anubhav96gupta/EMG-Analysis-and-Application-for-Arm-Exoskeleton-Control/Schematic/DIGITAL.pdf

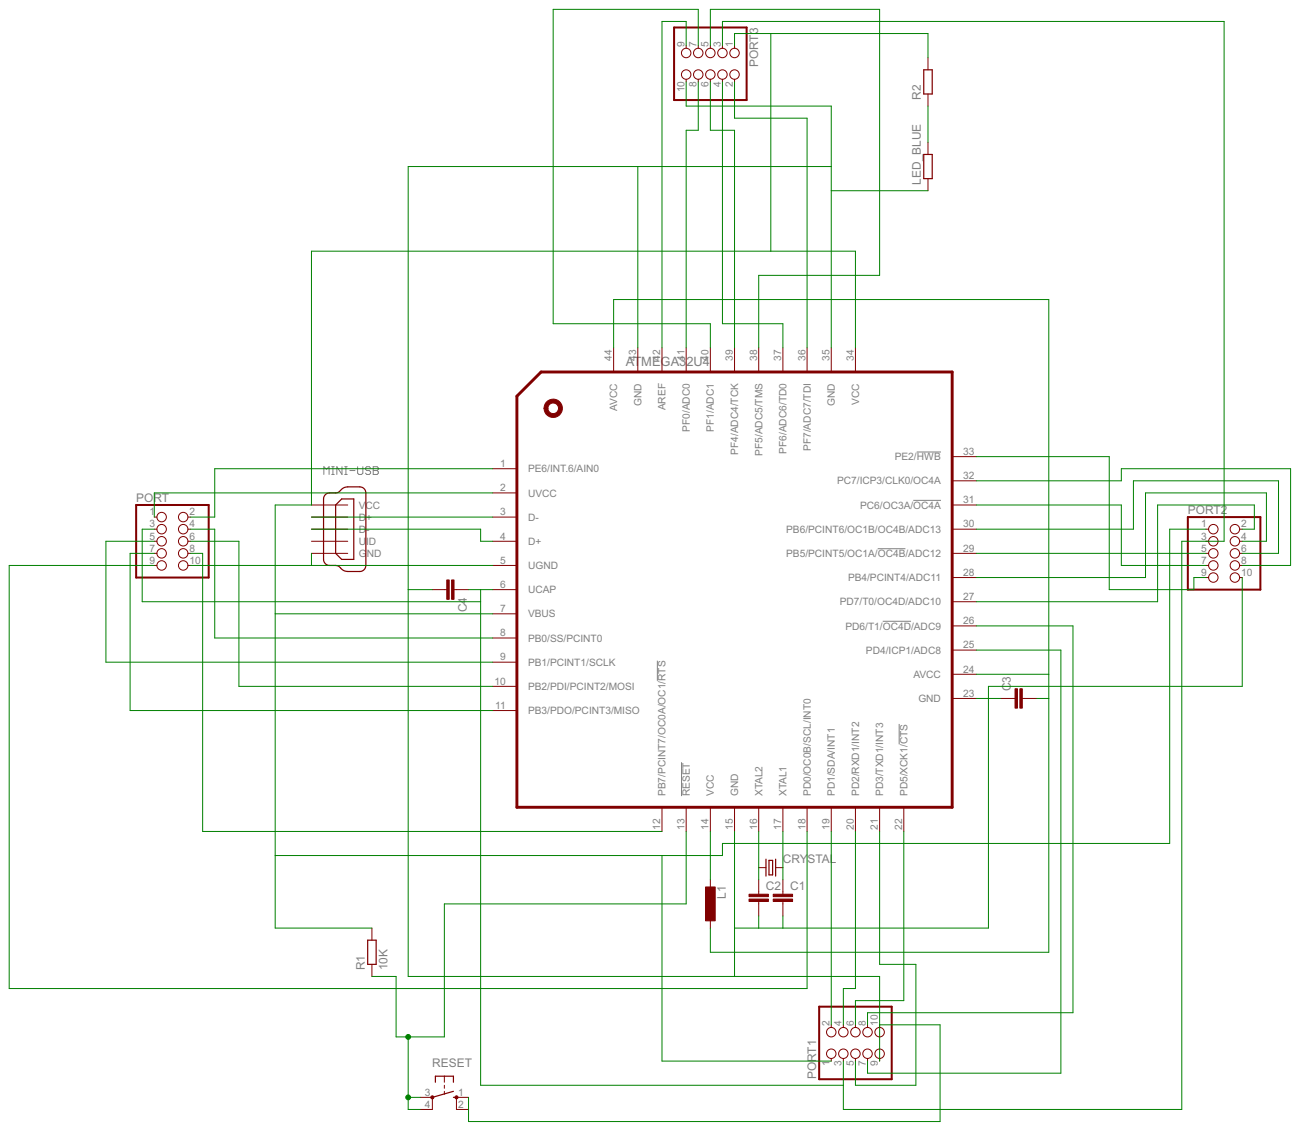
[picture p68: page 1]

10K ATMEGA32U4 PF0/ADC0 41 PF4/ADC4/TCK 39 PF5/ADC5/TMS 38 PB1/PCINT1/SCLK 9 GND 15 VCC 14 PD0/OC0B/SCL/INT0 18 AVCC 24 PF1/ADC1 40 AREF 42 PB2/PDI/PCINT2/MOSI 10 GND 23 PB7/PCINT7/OC0A/OC1/RTS 12 PD1/SDA/INT1 19 GND 35 PE2/HWB P33 F6/ADC6/TD0 37 PB3/PDO/PCINT3/MISO 11 PD2/RXD1/INT2 20 PD3/TXD1/INT3 21 PD5/XCK1/CTS 22 XTAL1 17 GND 43 PF7/ADC7/TDI 36 PB0/SS/PCINT0 8 PD4/ICP1/ADC8 25 PD6/T1/OC4D/ADC9 26 XTAL2 16 RESET 13 PC7/ICP3/CLK0/OC4A 32 PB4/PCINT4/ADC11 28 PD7/T0/OC4D/ADC10 27 D+ 4 D- 3 UCAP 6 PE6/INT.6/AIN0 1 PB5/PCINT5/OC1A/OC4B/ADC12 29 VCC 34 UVCC 2 AVCC 44 UGND 5 VBUS 7 PC6/OC3A/OC4A 31 PB6/PCINT6/OC1B/OC4B/ADC13 30 CRYSTAL C2 C1 L1 C3 VCC D+D- UID GND C4 PORT2 1 2 3 4 5 6 7 8 9 10 1 2 3 4 5 6 7 8 9 10 PORT3 PORT1 1 2 3 4 5 6 7 8 9 10 PORT 1 2 3 4 5 6 7 8 9 10 RESET 3 1 4 2 R1 R2 LED_BLUE
