anubhav96gupta/EMG-Analysis-and-Application-for-Arm-Exoskeleton-Control/Schematic/ANALOG.pdf

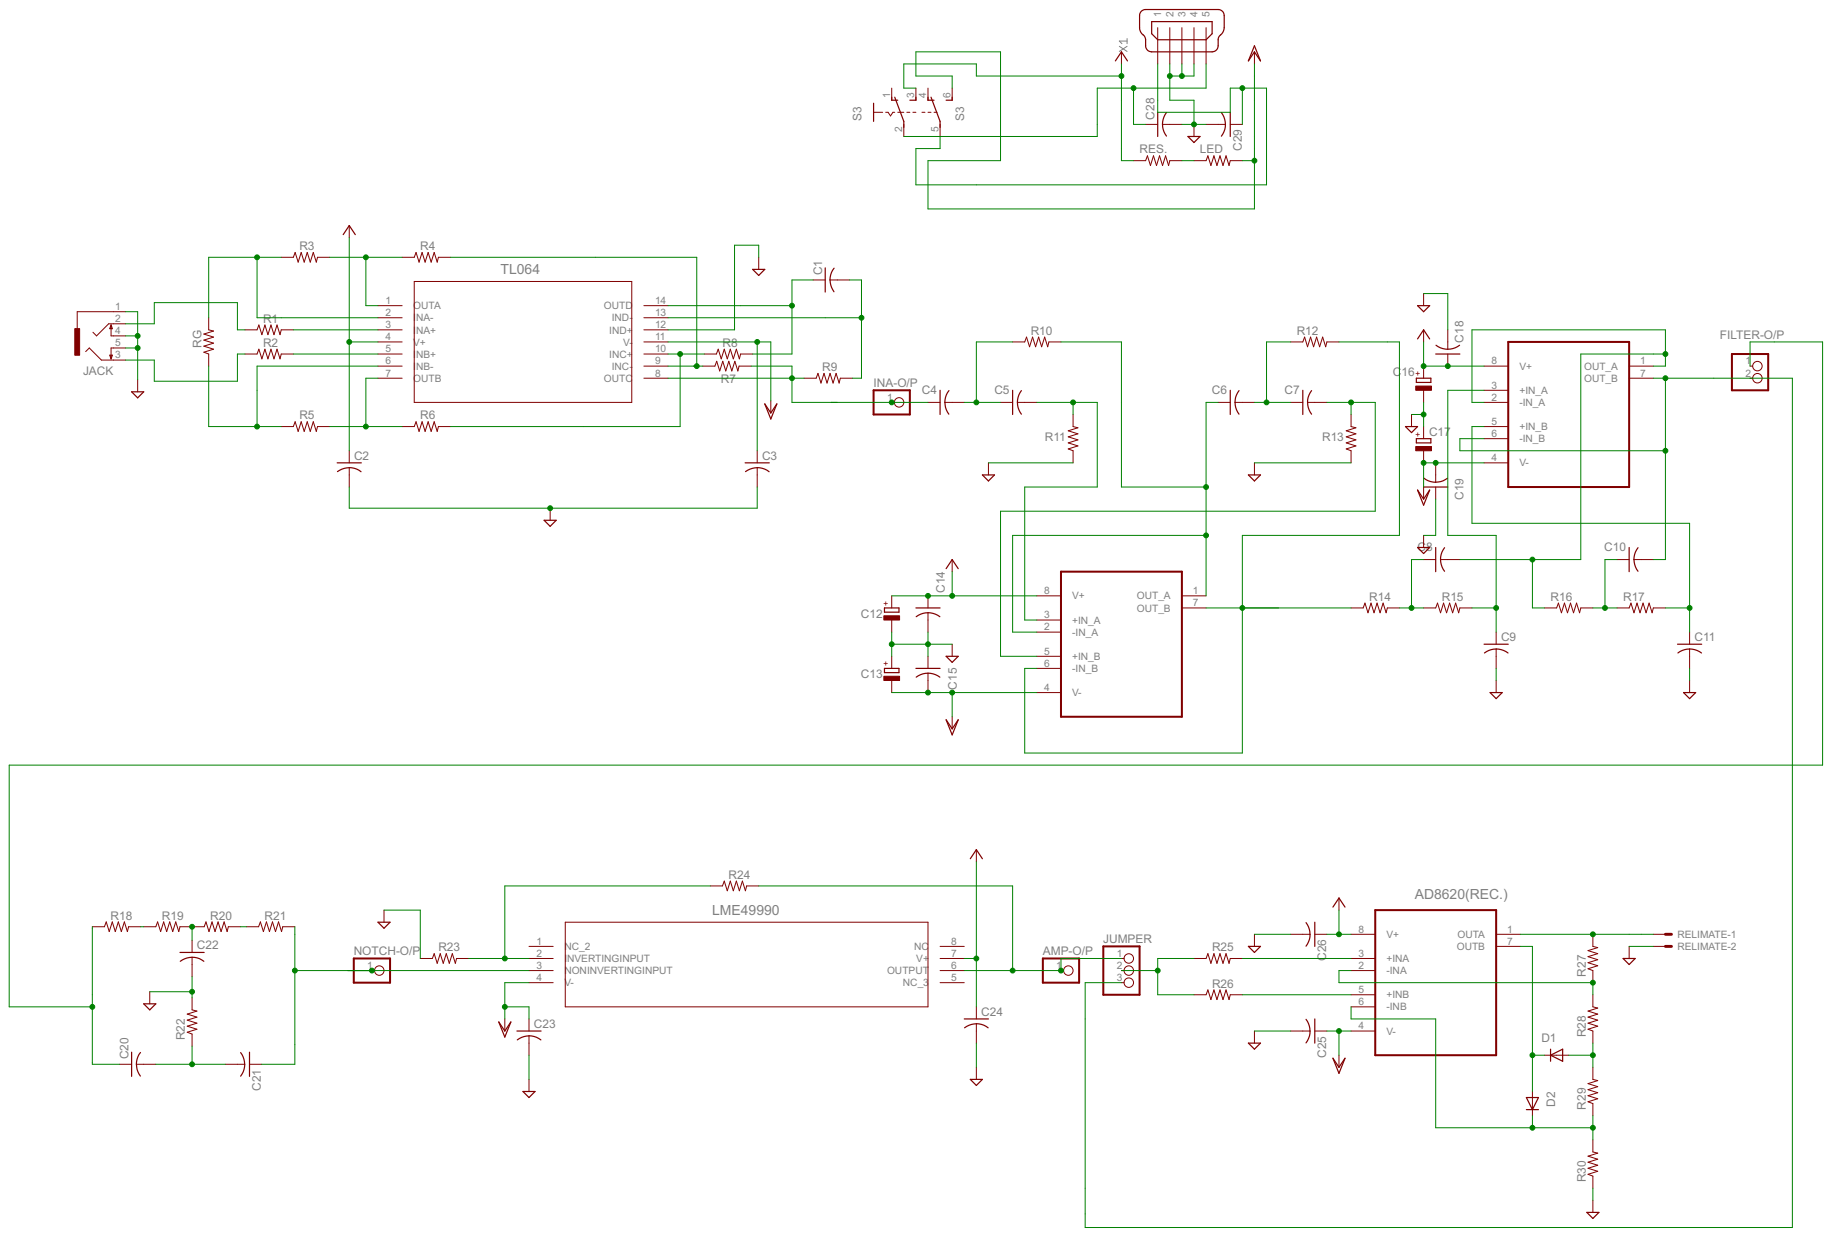
[picture p69: page 1]
