anubhav96gupta/EMG-Analysis-and-Application-for-Arm-Exoskeleton-Control/(list of files, drawings)

Other design files:
Multisim Circuits/hpf.ms12
Multisim Circuits/lpf.ms12
Multisim Circuits/Rectifier.ms12
Multisim Circuits/tl061notch.ms12
