anubhav96gupta/EMG-Analysis-and-Application-for-Arm-Exoskeleton-Control/Eagle/Digital/Socket.brd

## EAGLE design Eagle/Digital/Socket.brd (2016-12-27)

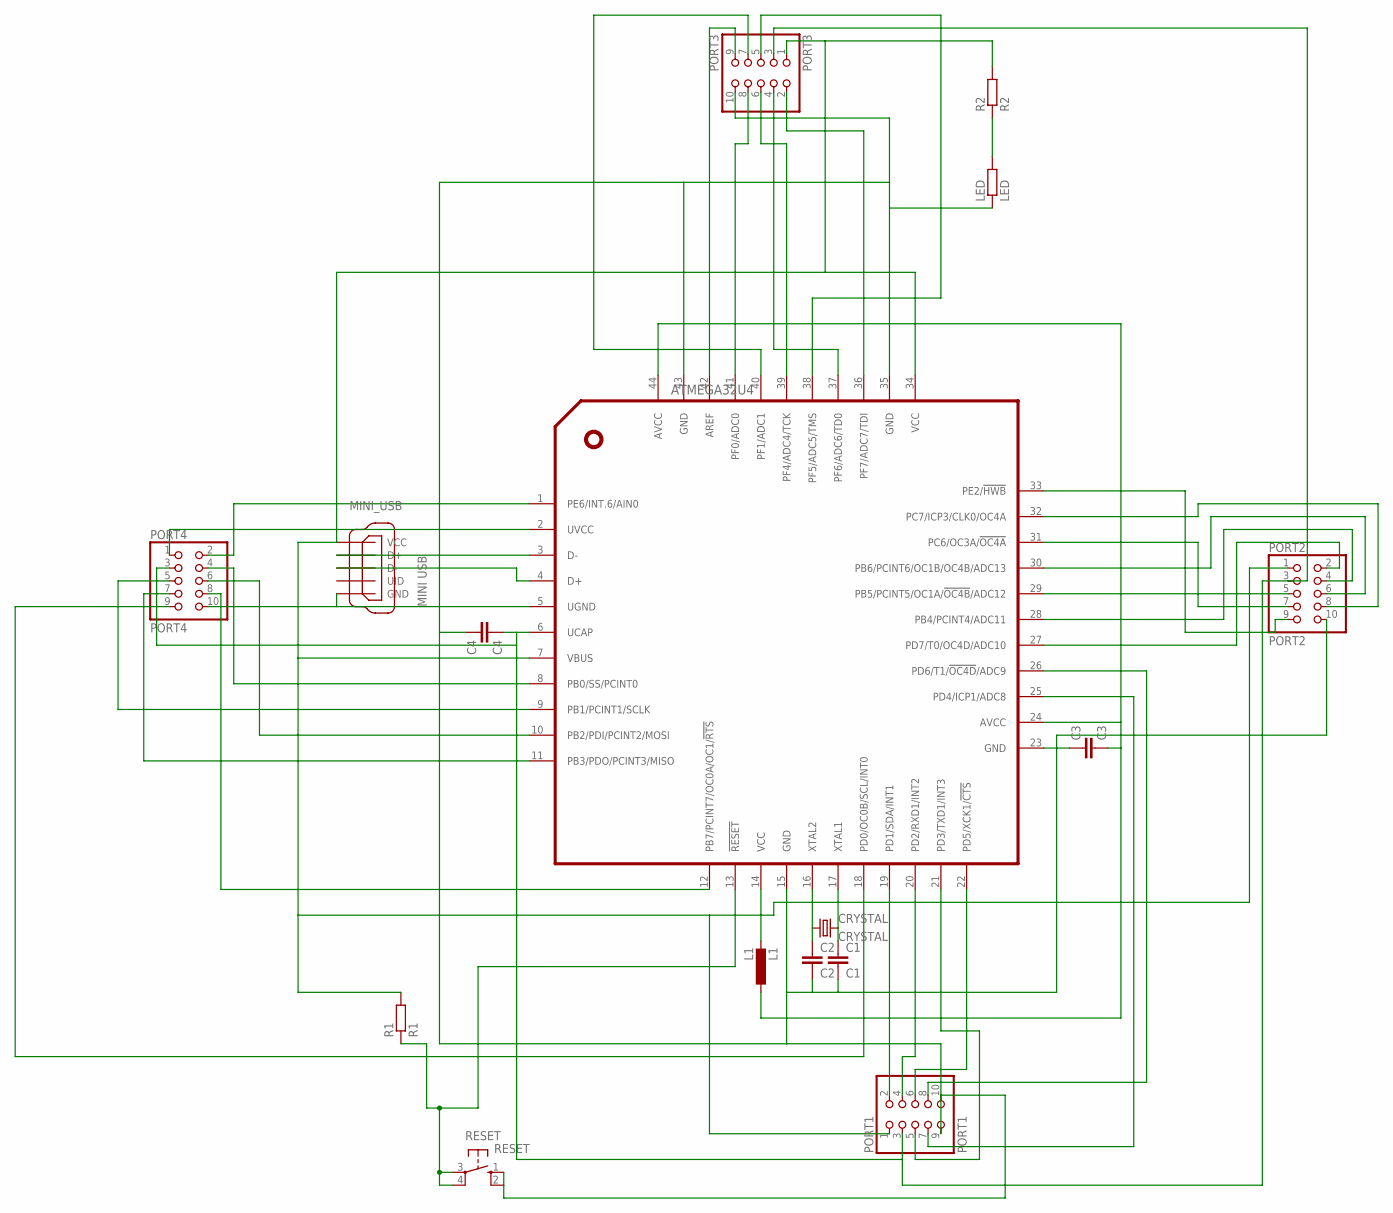
[picture p70: schematic Socket.sch]

Parts:
ATMEGA32U4: ATMEGA32U4; TQFP44
C1: C1; C0603
C2: C2; C0603
C3: C3; C0603
C4: C4; C0603
CRYSTAL: CRYSTAL; HC49UP
L1: L1; L2012C
LED: LED; R0603
MINI_USB: MINI USB; UX60-MB-5S8
PORT1: PORT1; 2X05
PORT2: PORT2; 2X05
PORT3: PORT3; 2X05
PORT4: PORT4; 2X05
R1: R1; R0603
R2: R2; R0603
RESET: RESET; B3F-10XX

Connections:
3.3VCC: ATMEGA32U4.6 (UCAP), C4.1, PORT1.3, PORT2.3, PORT3.3, PORT4.3
5VCC: ATMEGA32U4.2 (UVCC), ATMEGA32U4.7 (VBUS), ATMEGA32U4.14 (VCC), ATMEGA32U4.34 (VCC), L1.2, MINI_USB.VCC, PORT1.1, PORT2.1, PORT3.1, PORT4.1, R1.2, R2.2
D+: ATMEGA32U4.4 (D+), MINI_USB.D-
GND: ATMEGA32U4.5 (UGND), ATMEGA32U4.15 (GND), ATMEGA32U4.23 (GND), ATMEGA32U4.35 (GND), ATMEGA32U4.43 (GND), C1.2, C2.2, C3.1, C4.2, LED.1, MINI_USB.GND, MINI_USB.GND1 (GND), MINI_USB.GND2 (GND), MINI_USB.GND3 (GND), MINI_USB.GND4 (GND), PORT1.9, PORT1.10, PORT2.10, PORT3.10, PORT4.10, RESET.1 (S), RESET.2 (S1)
unnamed: ATMEGA32U4.16 (XTAL2), C2.1, CRYSTAL.1
unnamed: ATMEGA32U4.17 (XTAL1), C1.1, CRYSTAL.2
unnamed: ATMEGA32U4.1 (PE6/INT.6/AIN0), PORT4.2
unnamed: LED.2, R2.1
unnamed: ATMEGA32U4.24 (AVCC), ATMEGA32U4.44 (AVCC), C3.2, L1.1
unnamed: ATMEGA32U4.8 (PB0/SS/PCINT0), PORT4.4
unnamed: ATMEGA32U4.9 (PB1/PCINT1/SCLK), PORT4.5
unnamed: ATMEGA32U4.3 (D-), MINI_USB.D+
unnamed: ATMEGA32U4.13 (!RESET), R1.1, RESET.3, RESET.4 (P1)
unnamed: ATMEGA32U4.10 (PB2/PDI/PCINT2/MOSI), PORT4.6
unnamed: ATMEGA32U4.11 (PB3/PDO/PCINT3/MISO), PORT4.7
unnamed: ATMEGA32U4.12 (PB7/PCINT7/OC0A/OC1/!RTS), PORT4.8
unnamed: ATMEGA32U4.18 (PD0/OC0B/SCL/INT0), PORT4.9
unnamed: ATMEGA32U4.19 (PD1/SDA/INT1), PORT1.2
unnamed: ATMEGA32U4.20 (PD2/RXD1/INT2), PORT1.4
unnamed: ATMEGA32U4.21 (PD3/TXD1/INT3), PORT1.5
unnamed: ATMEGA32U4.22 (PD5/XCK1/!CTS), PORT1.6
unnamed: ATMEGA32U4.25 (PD4/ICP1/ADC8), PORT1.7
unnamed: ATMEGA32U4.26 (PD6/T1/!OC4D!/ADC9), PORT1.8
unnamed: ATMEGA32U4.36 (PF7/ADC7/TDI), PORT3.2
unnamed: ATMEGA32U4.27 (PD7/T0/OC4D/ADC10), PORT2.2
unnamed: ATMEGA32U4.28 (PB4/PCINT4/ADC11), PORT2.4
unnamed: ATMEGA32U4.29 (PB5/PCINT5/OC1A/!OC4B!/ADC12), PORT2.5
unnamed: ATMEGA32U4.30 (PB6/PCINT6/OC1B/OC4B/ADC13), PORT2.6
unnamed: ATMEGA32U4.31 (PC6/OC3A/!OC4A), PORT2.7
unnamed: ATMEGA32U4.32 (PC7/ICP3/CLK0/OC4A), PORT2.8
unnamed: ATMEGA32U4.33 (PE2/!HWB), PORT2.9
unnamed: ATMEGA32U4.37 (PF6/ADC6/TD0), PORT3.4
unnamed: ATMEGA32U4.38 (PF5/ADC5/TMS), PORT3.5
unnamed: ATMEGA32U4.40 (PF1/ADC1), PORT3.7
unnamed: ATMEGA32U4.41 (PF0/ADC0), PORT3.8
unnamed: ATMEGA32U4.42 (AREF), PORT3.9
PORT3: ATMEGA32U4.39 (PF4/ADC4/TCK), PORT3.6

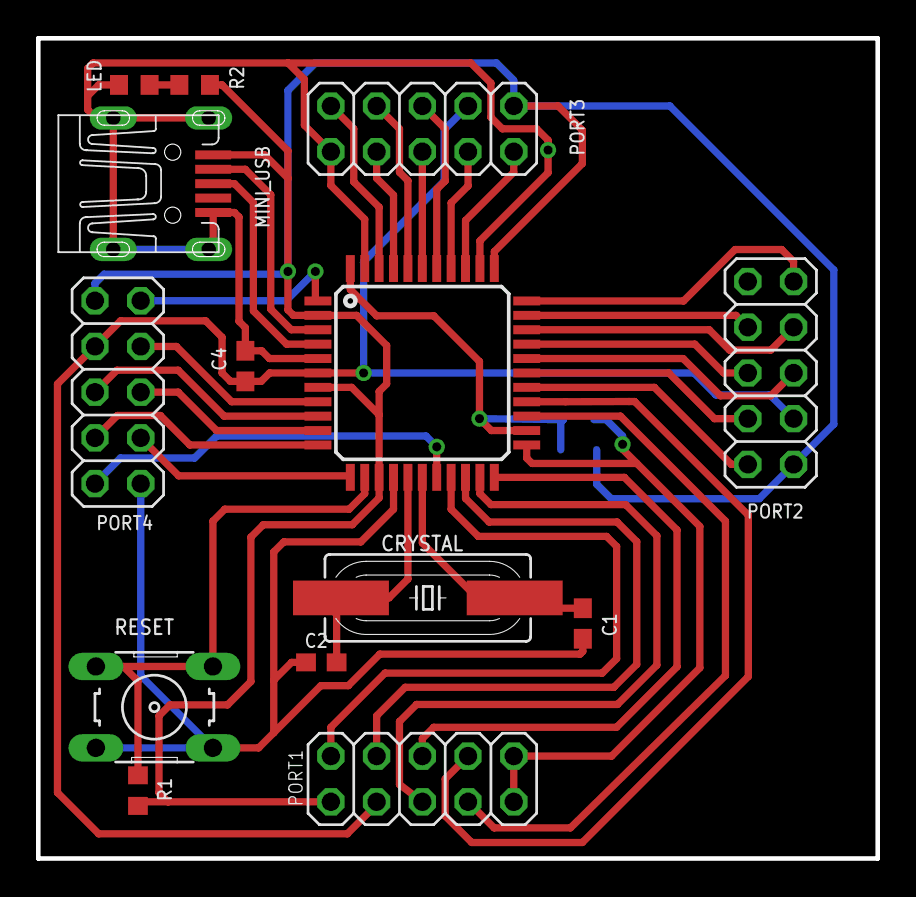
[picture p71: board Socket.brd from above]

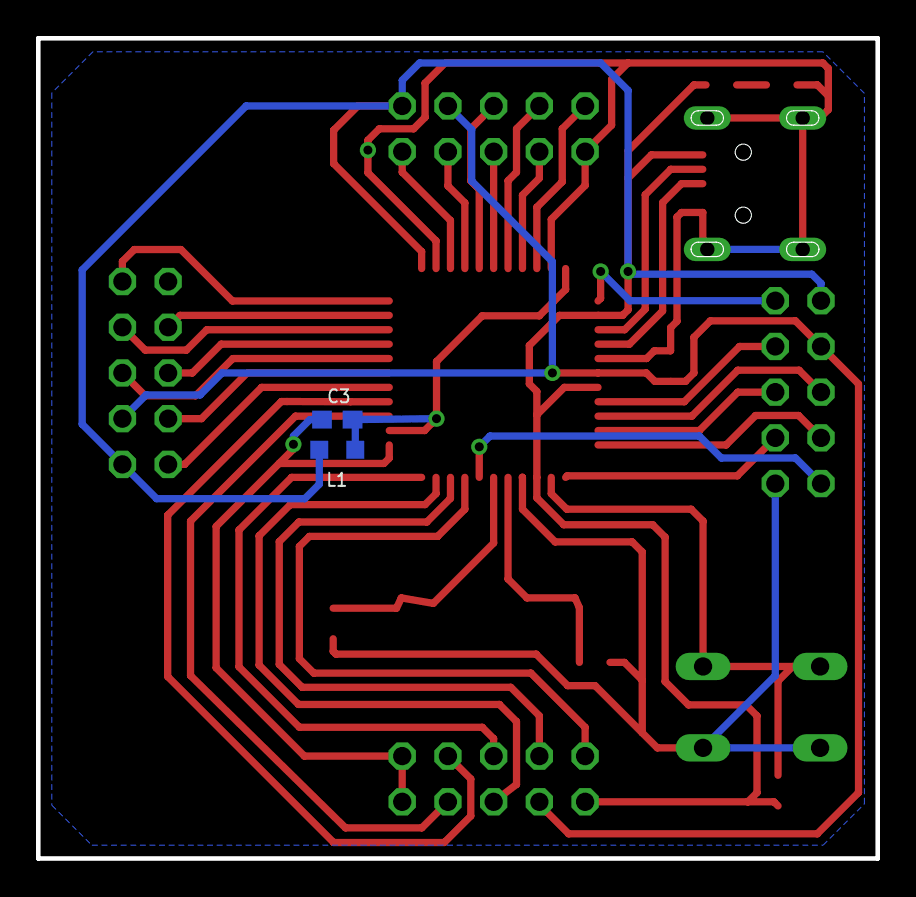
[picture p72: board Socket.brd from below]

Board: 2 copper layers, 46.6 x 45.6 mm, 16 parts (2 on the bottom side), 37 nets.
