anubhav96gupta/EMG-Analysis-and-Application-for-Arm-Exoskeleton-Control/Analog/oneboard.brd

## EAGLE design Analog/oneboard.brd (2016-12-27)

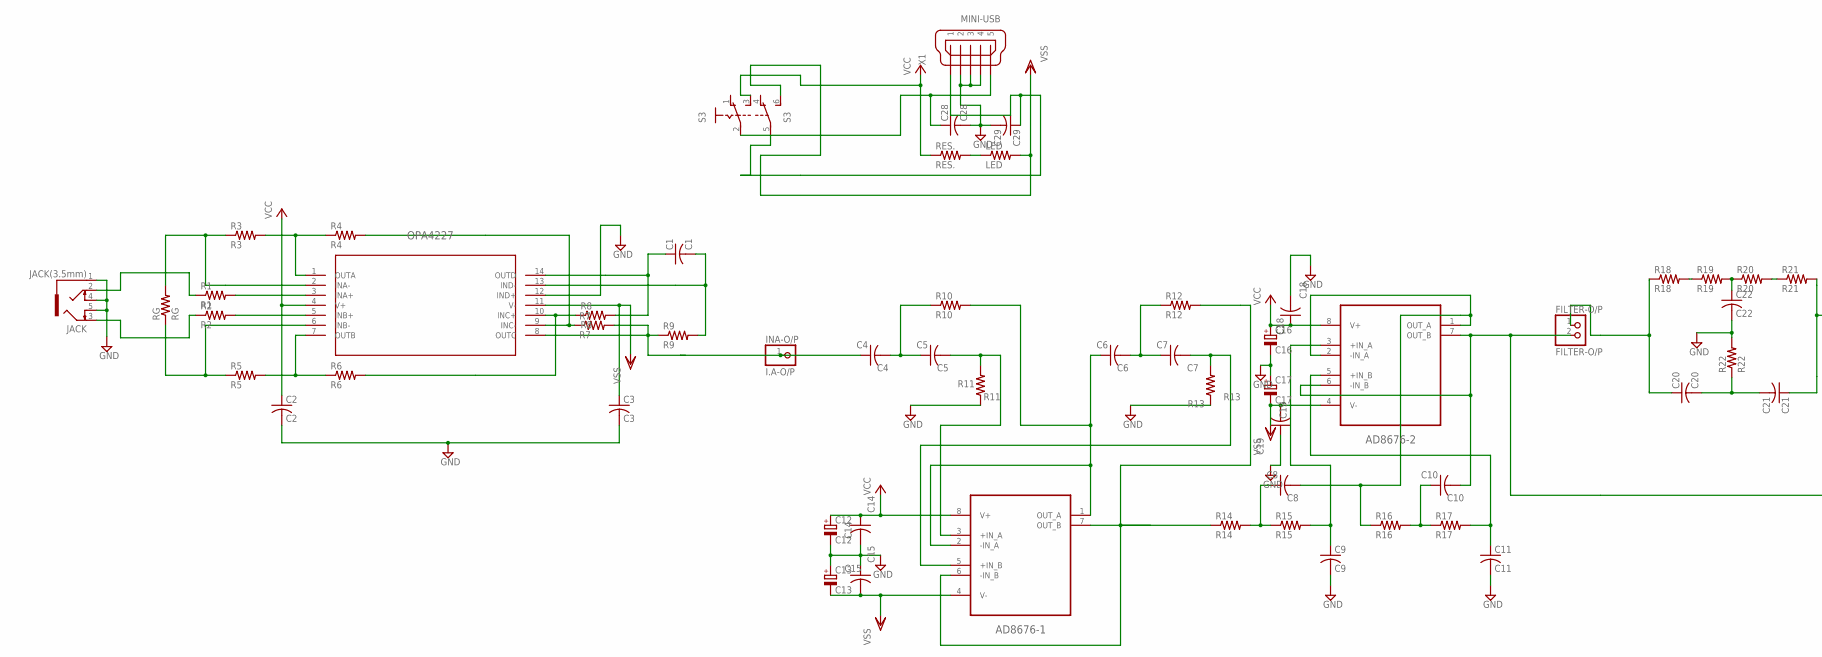
[picture p73: schematic oneboard.sch, part in row 1, column 1]

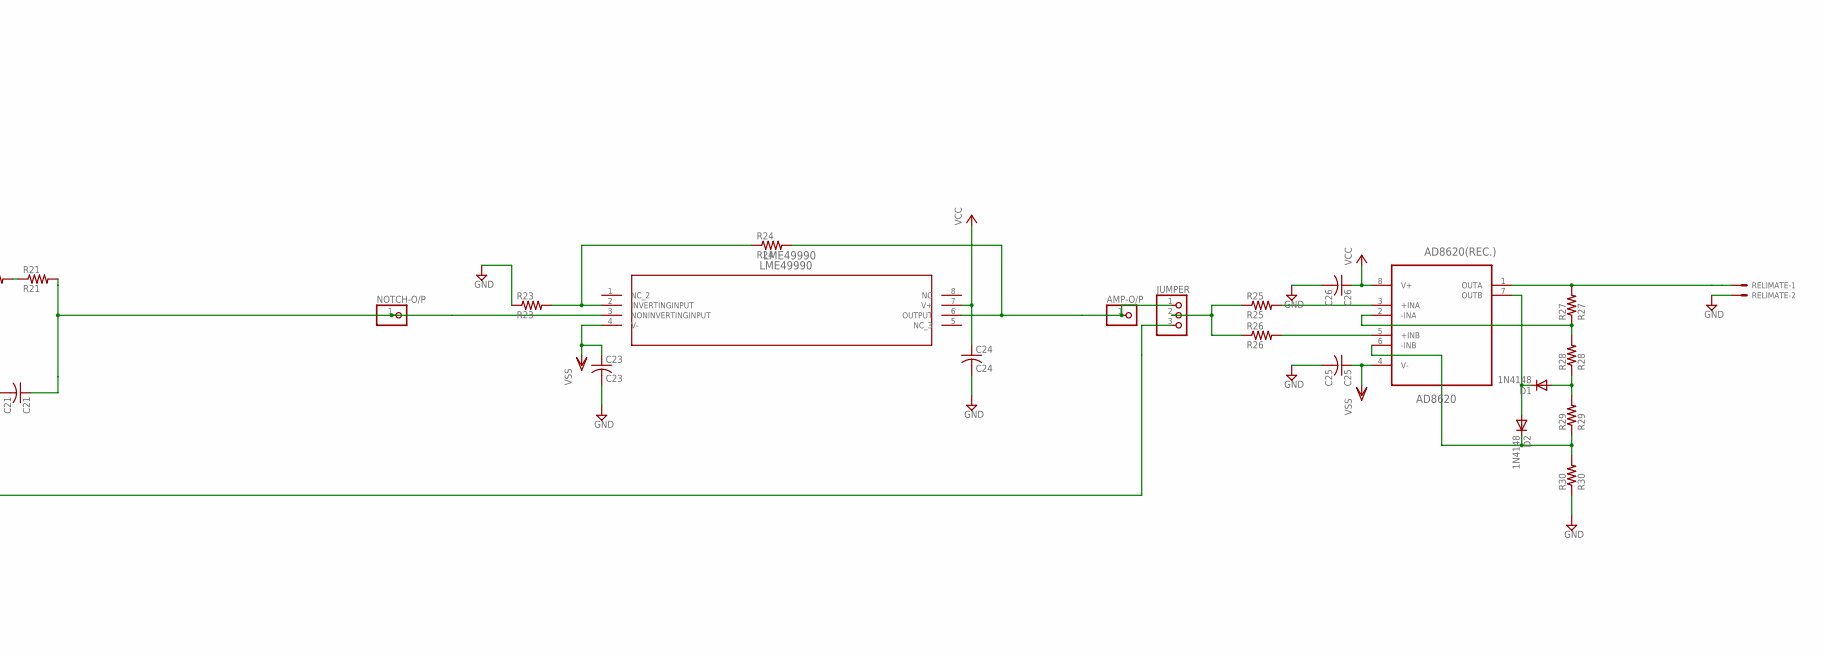
[picture p74: schematic oneboard.sch, part in row 1, column 2]

Parts:
AD8620(REC.): AD8620; SOIC127P600X175-8N
AD8676-1: AD8676-1; SOIC127P600X175-8N
AD8676-2: AD8676-2; SOIC127P600X175-8N
AMP-O/P: PINHD-1X1; 1X01
C1: C1; C0603
C2: C2; C0603
C3: C3; C0603
C4: C4; C0603
C5: C5; C0603
C6: C6; C0603
C7: C7; C0603
C8: C8; C0603
C9: C9; C0603
C10: C10; C0603
C11: C11; C0603
C12: C12; E2-5
C13: C13; E2-5
C14: C14; C0603
C15: C15; C0603
C16: C16; E2-5
C17: C17; E2-5
C18: C18; C0603
C19: C19; C0603
C20: C20; C0603
C21: C21; C0603
C22: C22; C0603
C23: C23; C0603
C24: C24; C0603
C25: C25; C0603
C26: C26; C0603
C28: C28; C0603
C29: C29; C0603
D1, D2: 1N4148; DO35-10
FILTER-O/P: FILTER-O/P; 1X02
INA-O/P: I.A-O/P; 1X01
JACK: JACK(3.5mm); 1503_09
JUMPER: PINHD-1X3; 1X03
LED: LED; R0805
LME49990: LME49990; M08A
NOTCH-O/P: PINHD-1X1; 1X01
OPA4227: OPA4277_D_14; D14
R1: R1; R0603
R2: R2; R0603
R3: R3; R0603
R4: R4; R0603
R5: R5; R0603
R6: R6; R0603
R7: R7; R0603
R8: R8; R0603
R9: R9; R0603
R10: R10; R0603
R11: R11; R0603
R12: R12; R0603
R13: R13; R0603
R14: R14; R0603
R15: R15; R0603
R16: R16; R0603
R17: R17; R0603
R18: R18; R0603
R19: R19; R0603
R20: R20; R0603
R21: R21; R0603
R22: R22; R0603
R23: R23; R0603
R24: R24; R0603
R25: R25; R0603
R26: R26; R0603
R27: R27; R0603
R28: R28; R0603
R29: R29; R0603
R30: R30; R0603
RELIMATE: 22-23-2021
RES.: RES.; R0603
RG: RG; R0603
S3: A68-A31
X1: MINI-USB; UX60-MB-5S8

Connections:
1: C21.1, LME49990.3 (NONINVERTINGINPUT), NOTCH-O/P.1, R21.2
5: C29.1, S3.5, X1.1
GND: C2.2, C3.2, C9.2, C11.2, C12.-, C13.+, C14.2, C15.1, C16.-, C17.+, C18.2, C19.1, C22.2, C23.2, C24.2, C25.2, C26.2, C28.2, C29.2, JACK.1, JACK.4, JACK.5, OPA4227.12 (IND+), R11.1, R13.1, R22.2, R23.1, R30.1, RELIMATE.2, X1.2, X1.3, X1.4
H-O/P: AD8676-1.6 (-IN_B), AD8676-1.7 (OUT_B), R12.2, R14.1
unnamed: OPA4227.3 (INA+), R1.2
unnamed: OPA4227.5 (INB+), R2.2
unnamed: JACK.3, R2.1
unnamed: JACK.2, R1.1
unnamed: OPA4227.1 (OUTA), R3.2, R4.1
unnamed: OPA4227.2 (INA-), R3.1, RG.2
unnamed: OPA4227.9 (INC-), R4.2, R7.1
unnamed: OPA4227.6 (INB-), R5.1, RG.1
unnamed: OPA4227.10 (INC+), R6.2, R8.1
unnamed: C1.2, OPA4227.13 (IND-), R9.2
unnamed: C4.2, C5.1, R10.1
unnamed: C1.1, OPA4227.14 (OUTD), R8.2
unnamed: C4.1, INA-O/P.1, OPA4227.8 (OUTC), R7.2, R9.1
unnamed: AD8676-1.3 (+IN_A), C5.2, R11.2
unnamed: AD8676-1.1 (OUT_A), AD8676-1.2 (-IN_A), C6.1, R10.2
unnamed: C6.2, C7.1, R12.1
unnamed: AD8676-1.5 (+IN_B), C7.2, R13.2
unnamed: C8.1, R14.2, R15.1
unnamed: AD8676-2.3 (+IN_A), C9.1, R15.2
unnamed: C10.1, R16.2, R17.1
unnamed: AD8676-2.5 (+IN_B), C11.1, R17.2
unnamed: AD8676-2.1 (OUT_A), AD8676-2.2 (-IN_A), C8.2, R16.1
unnamed: AD8620(REC.).3 (+INA), R25.2
unnamed: C22.1, R19.2, R20.1
unnamed: LED.1, RES..2
unnamed: C20.2, C21.2, R22.1
unnamed: R18.2, R19.1
unnamed: R20.2, R21.1
unnamed: AD8620(REC.).5 (+INB), R26.2
unnamed: JUMPER.2, R25.1, R26.1
unnamed: AD8676-2.6 (-IN_B), AD8676-2.7 (OUT_B), C10.2, FILTER-O/P.2, JUMPER.3
unnamed: C20.1, FILTER-O/P.1, R18.1
unnamed: AD8620(REC.).2 (-INA), R27.1, R28.2
unnamed: AD8620(REC.).1 (OUTA), R27.2, RELIMATE.1
unnamed: D1.A, R28.1, R29.2
unnamed: AD8620(REC.).6 (-INB), D2.C, R29.1, R30.2
unnamed: AD8620(REC.).7 (OUTB), D1.C, D2.A
unnamed: LME49990.2 (INVERTINGINPUT), R23.2, R24.1
unnamed: AMP-O/P.1, JUMPER.1, LME49990.6 (OUTPUT), R24.2
unnamed: C28.1, S3.2, X1.5
R6: OPA4227.7 (OUTB), R5.2, R6.1
VCC: AD8620(REC.).8 (V+), AD8676-1.8 (V+), AD8676-2.8 (V+), C2.1, C12.+, C14.1, C16.+, C18.1, C24.1, C26.1, LME49990.7 (V+), OPA4227.4 (V+), RES..1, S3.3 (S)
VSS: AD8620(REC.).4 (V-), AD8676-1.4 (V-), AD8676-2.4 (V-), C3.1, C13.-, C15.2, C17.-, C19.2, C23.1, C25.1, LED.2, LME49990.4 (V-), OPA4227.11 (V-), S3.6 (S)

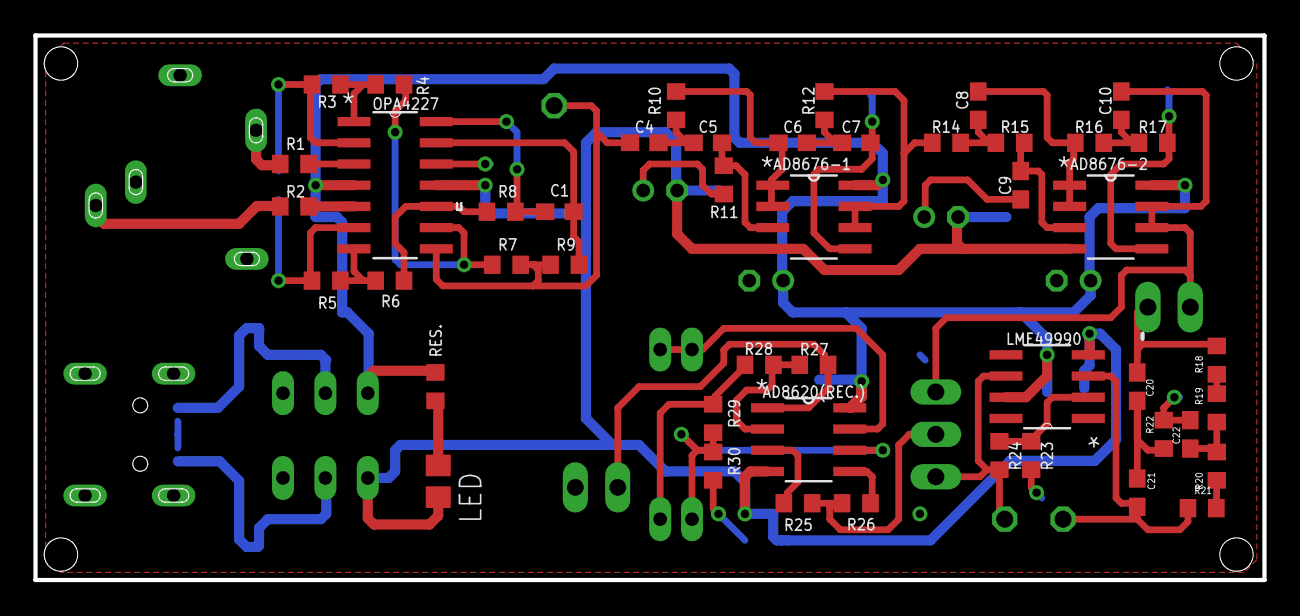
[picture p75: board oneboard.brd from above]

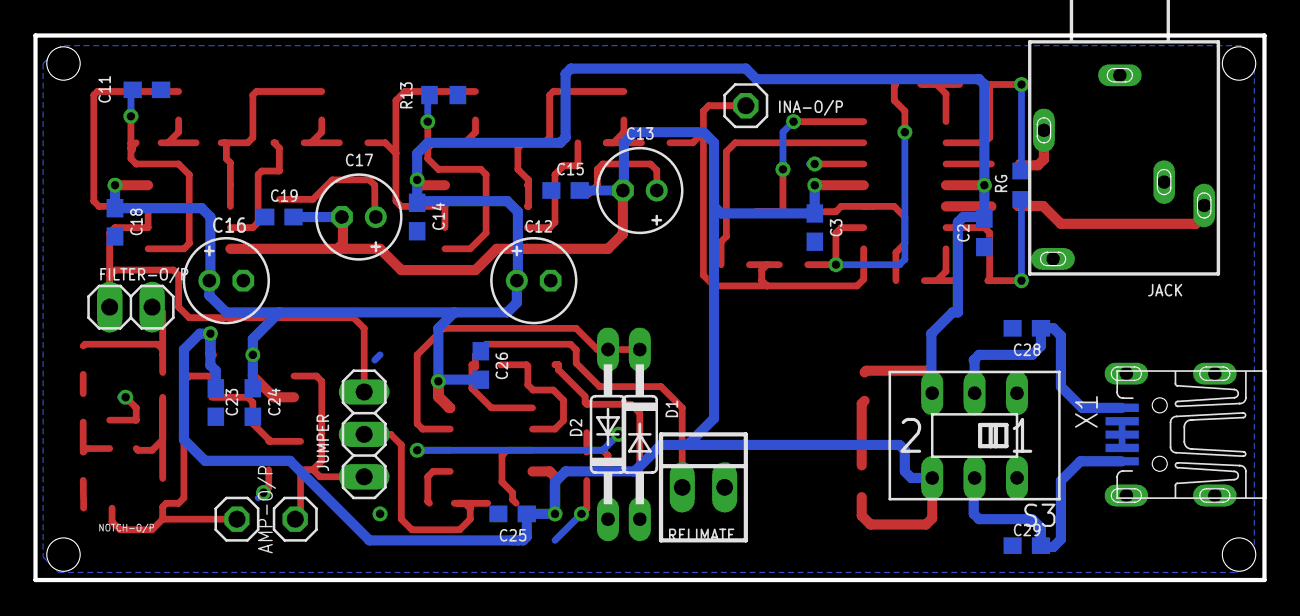
[picture p76: board oneboard.brd from below]

Board: 2 copper layers, 73.6 x 32.6 mm, 77 parts (30 on the bottom side), 47 nets.
