anubhav96gupta/EMG-Analysis-and-Application-for-Arm-Exoskeleton-Control/Eagle/Interface/inter.brd

## EAGLE design Eagle/Interface/inter.brd (2016-12-27)

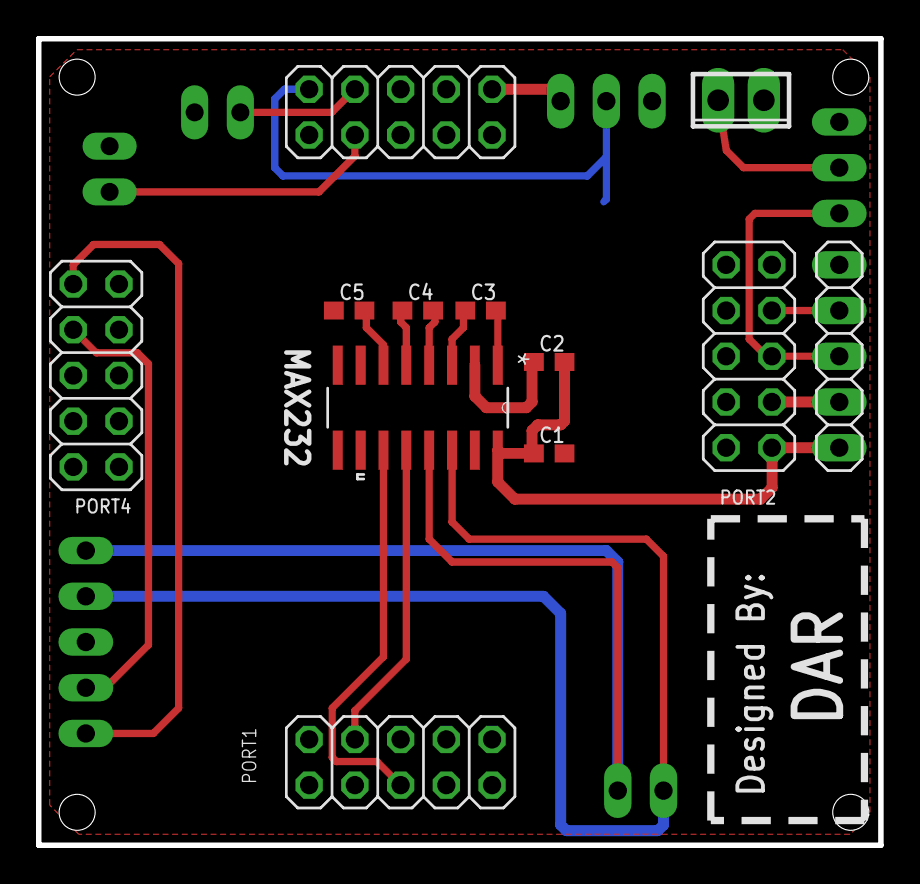
[picture p77: board inter.brd from above]

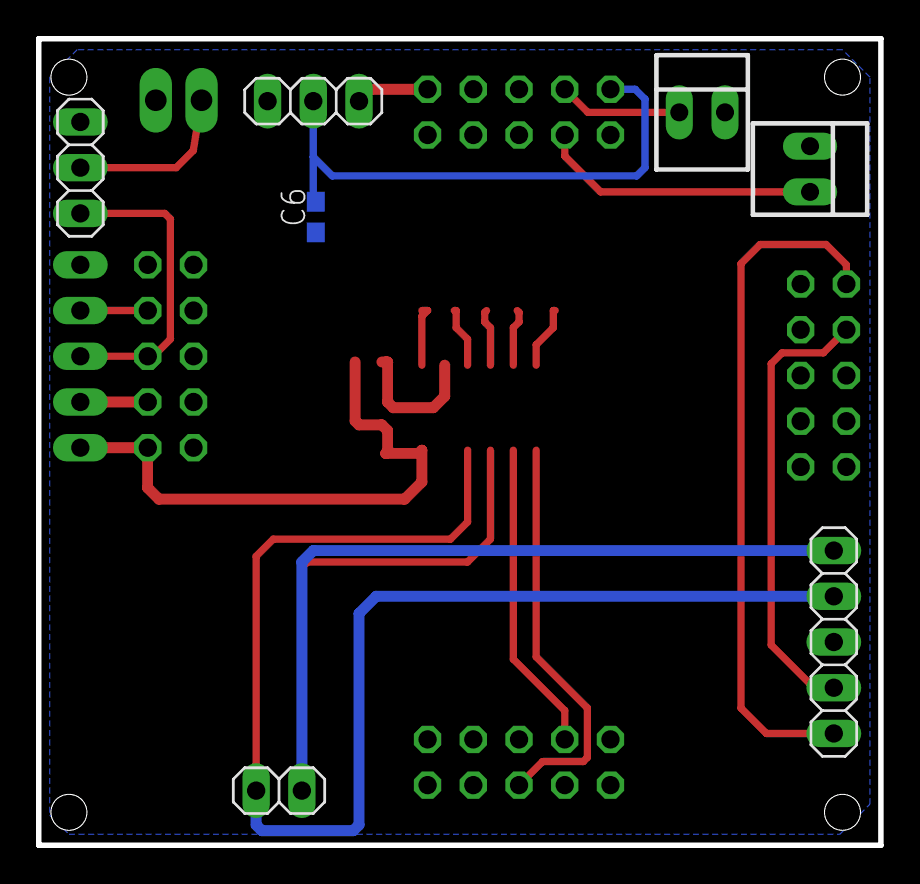
[picture p78: board inter.brd from below]

Board: 2 copper layers, 46.8 x 44.8 mm, 19 parts (7 on the bottom side), 23 nets.

Parts:
ADC-0, ADC-1: 22-23-2021
C1: C1; C0603
C2: C2; C0603
C3: C3; C0603
C4: C4; C0603
C5: C5; C0603
C6: C6; C0603
MAX232: MAX232; D16
MOTOR-SUPPLY: 2POL254
PORT1: PORT1; 2X05
PORT2: PORT2; 2X05
PORT3: PORT3; 2X05
PORT4: PORT4; 2X05
RX/TX: 1X02
SERVO: 1X03
SUPPLY: 1X05
VREF: 1X03
ZIGBEE: 1X05

Connections:
ADC-0: ADC-0.2, PORT3.8
C4: C4.2, MAX232.4
GND: ADC-0.1, ADC-1.2, C1.2, C5.1, C6.1, MOTOR-SUPPLY.1, PORT1.10, PORT2.10, PORT4.10, SERVO.1, VREF.1
S$1: C3.1, MAX232.3
S$2: C3.2, MAX232.1
S$4: C4.1, MAX232.5
S$6: PORT4.1, ZIGBEE.5
S$7: C1.1, C2.2, MAX232.16
S$8: C2.1, MAX232.2
S$9: C5.2, MAX232.6
S$10: C6.2, PORT3.9, VREF.2
S$11: MAX232.11, PORT1.5
S$12: MAX232.12, PORT1.4
S$13: PORT2.1, SUPPLY.1
S$14: PORT2.3, SUPPLY.2
S$15: PORT2.5, SERVO.3, SUPPLY.3
S$16: PORT2.7, SUPPLY.4
S$17: MOTOR-SUPPLY.2, SERVO.2
S$18: MAX232.13, RX/TX.1, ZIGBEE.1
S$19: MAX232.14, RX/TX.2, ZIGBEE.2
S$21: ADC-1.1, PORT3.7
S$23: PORT3.1, VREF.3
S$24: PORT4.3, ZIGBEE.4
